iricryst/4mb-mapper-nms8280/KICAD/4mbmapper.png

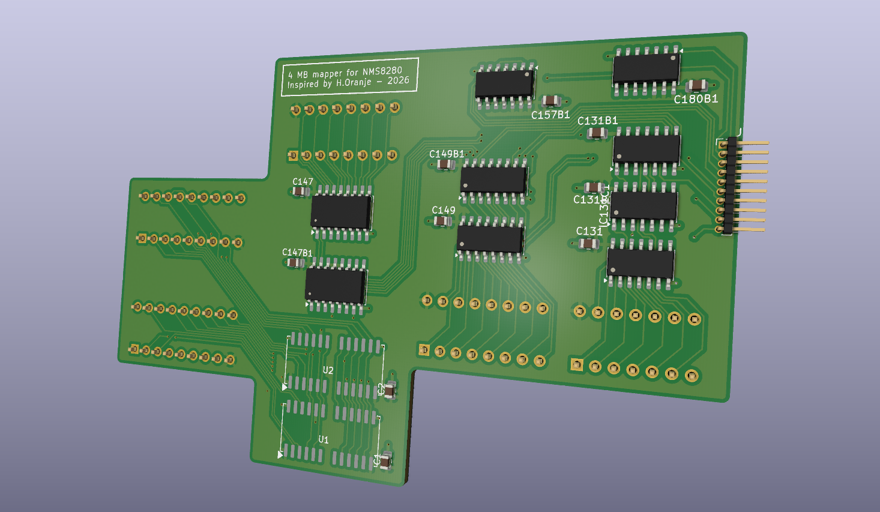
KICAD/4mbmapper.png
