iricryst/4mb-mapper-nms8280/KICAD/pinout.png

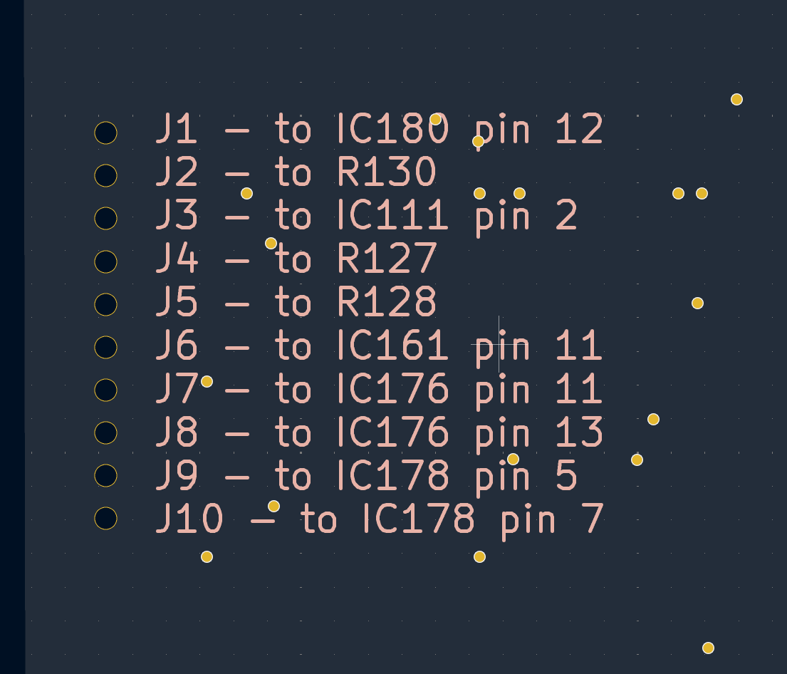
KICAD/pinout.png
