iricryst/4mb-mapper-nms8280/kicad_alll_smd/4mbmapper_back.png

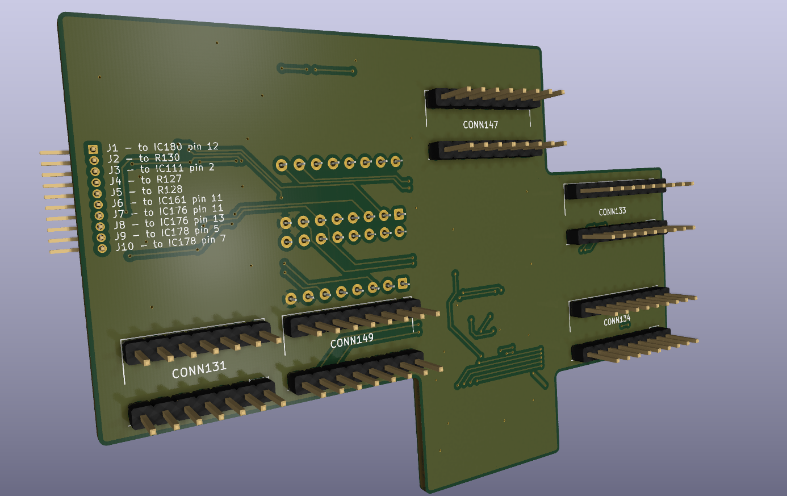
kicad_alll_smd/4mbmapper_back.png
