iricryst/4mb-mapper-nms8280/KICAD/4mb mapper nms8280.kicad_pcb

## KiCad design KICAD/4mb mapper nms8280.kicad_pcb (2026-10-19)

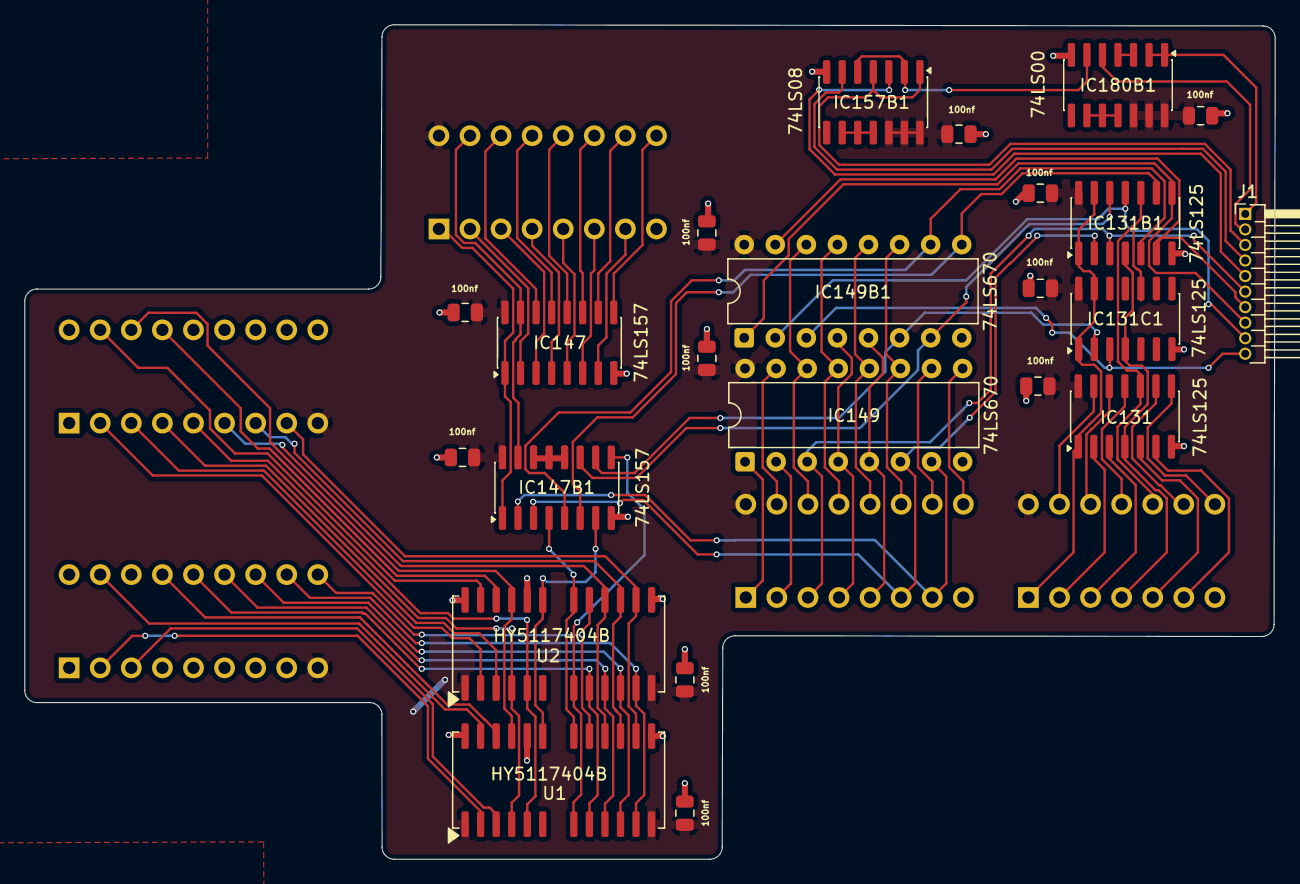
[picture p14: board 4mb mapper nms8280.kicad_pcb from above]

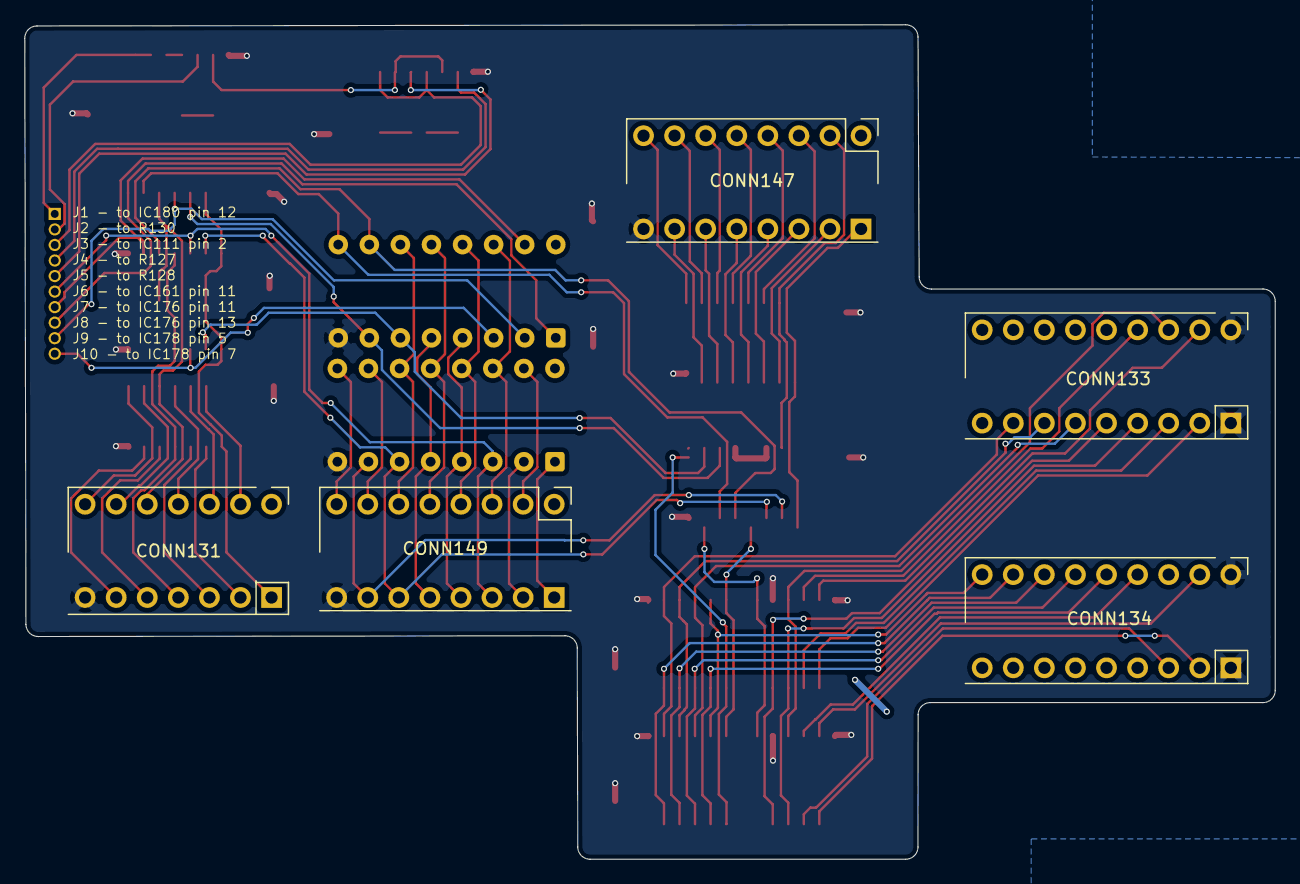
[picture p15: board 4mb mapper nms8280.kicad_pcb from below]

Board: 2 copper layers, 102.2 x 68.2 mm, 28 parts (5 on the bottom side), 82 nets.

Parts:
C1, C2, C131, C131B1, C131B2, C147, C147B1, C149, C149B1, C157B1, C180B1: 100nf; C_0805_2012Metric
CONN131: Pin Header 2x7 2,54mm Rounded; PinHeader_2x07_P2.54mm_Vertical
CONN133, CONN134: Pin Header 2x9 2,54mm Rounded; PinHeader_2x09_P2.54mm_Vertical
CONN147, CONN149: Pin Header 2x8 2,54mm Rounded; PinHeader_2x08_P2.54mm_Vertical
IC131, IC131B1, IC131C1: 74LS125; SOIC-14_3.9x8.7mm_P1.27mm
IC147, IC147B1: 74LS157; SOIC-16_3.9x9.9mm_P1.27mm
IC149, IC149B1: 74LS670; DIP-16_W7.62mm
IC157B1: 74LS08; SOIC-14_3.9x8.7mm_P1.27mm
IC180B1: 74LS00; SOIC-14_3.9x8.7mm_P1.27mm
J1: Conn_01x10_Pin; PinHeader_1x10_P1.27mm_Horizontal
U1, U2: HY5117404B; SOJ-2624_7.62x18.415mm_P1.27mm

Connections:
/4mb mapper nms8280/131b_131c_p13: CONN131.1 (1A), IC131.1 (1E), IC131B1.1 (1E), IC131B1.13 (4E), IC131C1.1 (1E), IC131C1.13 (4E)
/4mb mapper nms8280/<NO NET>: IC180B1.1 (1A), IC180B1.2 (1B), J1.1
/4mb mapper nms8280/IC131_P2: CONN131.2 (1B), IC131.2 (1D)
/4mb mapper nms8280/IC131_P3: CONN131.3 (1Y), IC131.3 (1O)
/4mb mapper nms8280/IC131_P4_IC131B: CONN131.4 (2A), IC131.4 (2E), IC131B1.4 (2E), IC131C1.4 (2E)
/4mb mapper nms8280/IC131_P5: CONN131.5 (2B), IC131.5 (2D)
/4mb mapper nms8280/IC131_P6: CONN131.6 (2Y), IC131.6 (2O)
/4mb mapper nms8280/IC131_P8: CONN131.8 (3Y), IC131.8 (3O)
/4mb mapper nms8280/IC131_P9: CONN131.9 (3A), IC131.9 (3D)
/4mb mapper nms8280/IC131_P10_IC131B: CONN131.10 (3B), IC131.10 (3E), IC131B1.10 (3E), IC131C1.10 (3E)
/4mb mapper nms8280/IC131_P11: CONN131.11 (4Y), IC131.11 (4O)
/4mb mapper nms8280/IC131_P12: CONN131.12 (4A), IC131.12 (4D)
/4mb mapper nms8280/IC131_P13: CONN131.13 (4B), IC131.13 (4E)
/4mb mapper nms8280/IC147_P1_IC147B: CONN147.1 (S), IC147.1 (S), IC147B1.1 (S)
/4mb mapper nms8280/IC147_P2: CONN147.2 (A0), IC147.2 (I0a)
/4mb mapper nms8280/IC147_P3: CONN147.3 (B0), IC147.3 (I1a)
/4mb mapper nms8280/IC147_P4: CONN147.4 (Y0), IC147.4 (Za)
/4mb mapper nms8280/IC147_P5: CONN147.5 (A1), IC147.5 (I0b)
/4mb mapper nms8280/IC147_P6: CONN147.6 (B1), IC147.6 (I1b)
/4mb mapper nms8280/IC147_P7: CONN147.7 (Y1), IC147.7 (Zb)
/4mb mapper nms8280/IC147_P9: CONN147.9 (Y2), IC147.9 (Zc)
/4mb mapper nms8280/IC147_P10: CONN147.10 (B2), IC147.10 (I1c)
/4mb mapper nms8280/IC147_P11: CONN147.11 (A2), IC147.11 (I0c)
/4mb mapper nms8280/IC147_P12: CONN147.12 (Y3), IC147.12 (Zd)
/4mb mapper nms8280/IC147_P13: CONN147.13 (B3), IC147.13 (I1d)
/4mb mapper nms8280/IC147_P14: CONN147.14 (A3), IC147.14 (I0d)
/4mb mapper nms8280/IC147_P15_IC147B: CONN147.15 (E), IC147.15 (E), IC147B1.15 (E)
/4mb mapper nms8280/IC149_P1: CONN149.1 (D2), IC149.1 (D2)
/4mb mapper nms8280/IC149_P2: CONN149.2 (D3), IC149.2 (D3)
/4mb mapper nms8280/IC149_P3: CONN149.3 (D4), IC131B1.3 (1O), IC149.3 (D4), J1.6
/4mb mapper nms8280/IC149_P4_IC149B: CONN149.4 (RB), IC149.4 (Rb), IC149B1.4 (Rb)
/4mb mapper nms8280/IC149_P5_IC149B: CONN149.5 (RA), IC149.5 (Ra), IC149B1.5 (Ra)
/4mb mapper nms8280/IC149_P6: CONN149.6 (Q4), IC131B1.2 (1D), IC147B1.3 (I1a), IC149.6 (Q4)
/4mb mapper nms8280/IC149_P7: CONN149.7 (Q3), IC147B1.2 (I0a), IC149.7 (Q3)
/4mb mapper nms8280/IC149_P9: CONN149.9 (Q2), IC149.9 (Q2)
/4mb mapper nms8280/IC149_P10: CONN149.10 (Q1), IC149.10 (Q1)
/4mb mapper nms8280/IC149_P11_IC149B: CONN149.11 (ER), IC149.11 (~Er), IC149B1.11 (~Er)
/4mb mapper nms8280/IC149_P12_IC149B: CONN149.12 (EW), IC149.12 (~Ew), IC149B1.12 (~Ew)
/4mb mapper nms8280/IC149_P13_IC149B: CONN149.13 (WB), IC149.13 (Wb), IC149B1.13 (Wb)
/4mb mapper nms8280/IC149_P14_IC149B: CONN149.14 (WA), IC149.14 (Wa), IC149B1.14 (Wa)
/4mb mapper nms8280/IC149_P15: CONN149.15 (D1), IC149.15 (D1)
/ram section/A0_IC133/134_P14: CONN134.14 (A0), U1.9 (A0), U2.9 (A0)
/ram section/A1_IC133/134_P13: CONN134.13 (A1), U1.10 (A1), U2.10 (A1)
/ram section/A2_IC133/134_P12: CONN134.12 (A2), U1.11 (A2), U2.11 (A2)
/ram section/A3_IC133/134_P11: CONN134.11 (A3), U1.12 (A3), U2.12 (A3)
/ram section/A4_IC133/134_P8: CONN133.8 (A4), U1.15 (A4), U2.15 (A4)
/ram section/A5_IC133/134_P7: CONN133.7 (A5), U1.16 (A5), U2.16 (A5)
/ram section/A6_IC133/134_P6: CONN133.6 (A6), U1.17 (A6), U2.17 (A6)
/ram section/A7_IC133/134_P10: CONN134.10 (A7), U1.18 (A7), U2.18 (A7)
/ram section/CAS_IC133/134_P16: CONN133.16 (CAS), U1.23 (CAS), U2.23 (CAS)
/ram section/D0_IC134_P2: CONN134.2 (D0), U1.2 (D0)
/ram section/D1_IC134_P3: CONN134.3 (D1), U1.3 (D1)
/ram section/D2_IC134_P15: CONN134.15 (D2), U1.24 (D2)
/ram section/D3_IC134_P17: CONN134.17 (D3), U1.25 (D3)
/ram section/D4_IC133_P2: CONN133.2 (D0), U2.2 (D0)
/ram section/D5_IC133_P3: CONN133.3 (D1), U2.3 (D1)
/ram section/D6_IC133_P15: CONN133.15 (D2), U2.24 (D2)
/ram section/D7_IC133_P17: CONN133.17 (D3), U2.25 (D3)
/ram section/RAS_IC133_P5: CONN133.5 (RAS), U1.5 (RAS), U2.5 (RAS)
/ram section/WE_IC133_P4: CONN133.4 (WE), U1.4 (WE), U2.4 (WE)
A8_IC147B_P4: IC147B1.4 (Za), U1.19 (A8), U2.19 (A8)
A9_IC147B_P7: IC147B1.7 (Zb), U1.21 (A9), U2.21 (A9)
A10_IC147B_P7: IC147B1.9 (Zc), U1.8 (A10), U2.8 (A10)
GND: C1.2, C2.2, C131.2, C131B1.2, C131B2.2, C147.1, C147B1.1, C149.2, C149B1.2, C157B1.1, C180B1.1, CONN131.7 (GND), CONN133.1 (OE), CONN133.18 (GND), CONN134.1 (OE), CONN134.18 (GND), CONN147.8 (GND), CONN149.8 (GND), IC131.7 (GND), IC131B1.7 (GND), IC131C1.7 (GND), IC147.8 (GND), IC147B1.8 (GND), IC149.8 (GND), IC149B1.8 (GND), IC157B1.7 (GND), IC180B1.7 (GND), U1.14 (GND), U1.22 (OE), U1.26 (GND), U2.14 (GND), U2.22 (OE), U2.26 (GND)
unnamed: IC131B1.5 (2D), IC147B1.5 (I0b), IC149B1.10 (Q1)
unnamed: IC131B1.6 (2O), IC149B1.15 (D1), J1.7
unnamed: IC131B1.9 (3D), IC147B1.6 (I1b), IC149B1.9 (Q2)
unnamed: IC131B1.8 (3O), IC149B1.1 (D2), J1.8
unnamed: IC131B1.12 (4D), IC147B1.11 (I0c), IC149B1.7 (Q3)
unnamed: IC131B1.11 (4O), IC149B1.2 (D3), J1.9
unnamed: IC131C1.2 (1D), IC147B1.10 (I1c), IC149B1.6 (Q4)
unnamed: IC131C1.3 (1O), IC149B1.3 (D4), J1.10
unnamed: IC147B1.12 (Zd), IC147B1.13 (I1d), IC147B1.14 (I0d)
unnamed: IC157B1.1 (1A), IC157B1.4 (2A), J1.3
unnamed: IC157B1.2 (1B), IC157B1.5 (2B), IC180B1.6 (2Y)
unnamed: IC157B1.3 (1Y), J1.5
unnamed: IC157B1.6 (2Y), J1.4
unnamed: IC157B1.9 (3A), IC157B1.10 (3B), IC157B1.11 (4Y)
unnamed: IC180B1.3 (1Y), IC180B1.4 (2A)
unnamed: IC180B1.5 (2B), J1.2
unnamed: IC180B1.9 (3A), IC180B1.10 (3B), IC180B1.11 (4Y)
Vcc: C1.1, C2.1, C131.1, C131B1.1, C131B2.1, C147.2, C147B1.2, C149.1, C149B1.1, C157B1.2, C180B1.2, CONN131.14 (Vcc), CONN133.9 (Vcc), CONN134.9 (Vcc), CONN147.16 (Vcc), CONN149.16 (Vcc), IC131.14 (Vcc), IC131B1.14 (Vcc), IC131C1.14 (Vcc), IC147.16 (VCC), IC147B1.16 (VCC), IC149.16 (VCC), IC149B1.16 (VCC), IC157B1.12 (4A), IC157B1.13 (4B), IC157B1.14 (Vcc), IC180B1.12 (4A), IC180B1.13 (4B), IC180B1.14 (Vcc), U1.1 (Vcc), U1.13 (Vcc), U2.1 (Vcc), U2.13 (Vcc)
