iricryst/4mb-mapper-nms8280/(commit log)

2026-10-19 Add assembly and wiring manual
2026-10-19 Revise README for clarity and accuracy
    Removed prototype warning and updated RAM information.
2026-10-19 Remove board images from README
    Removed board images section and related content from README.
2026-10-19 Fix formatting and grammar in README.md
    Corrected formatting and grammar in the Bill of Materials section.
2026-10-19 Add DIP socket pin image to BOM section
2026-10-19 Enhance README with assembly and testing details
    Added additional sections and images to the README for clarity on assembly and testing procedures.
2026-10-19 Update bill of materials with additional parts and notes
    Added specifications for pin headers and DIP sockets to the bill of materials. Included notes on part measurements and compatibility.
2026-10-19 Fix formatting in README Bill of Materials section
    Correct formatting of bullet points in the Bill of Materials section.
