iricryst/4mb-mapper-nms8280/img/mb_prepared.jpg

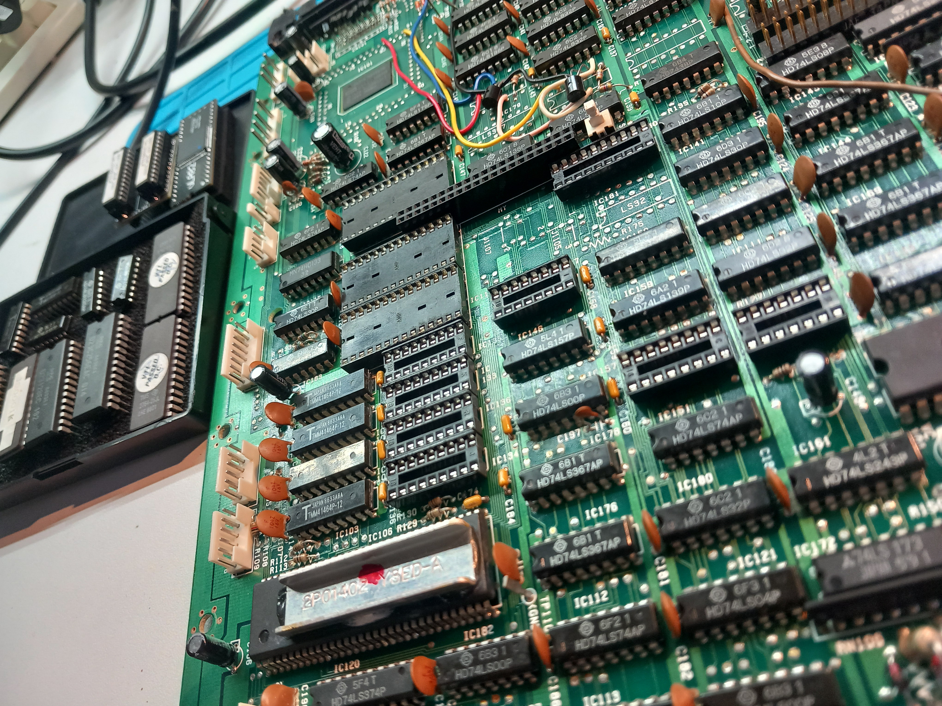
[picture p5: img/mb_prepared.jpg]
img/mb_prepared.jpg
